DVeldhurthi/halflifeweek1/README.md

# Half-Life Week 1: Design a PCB

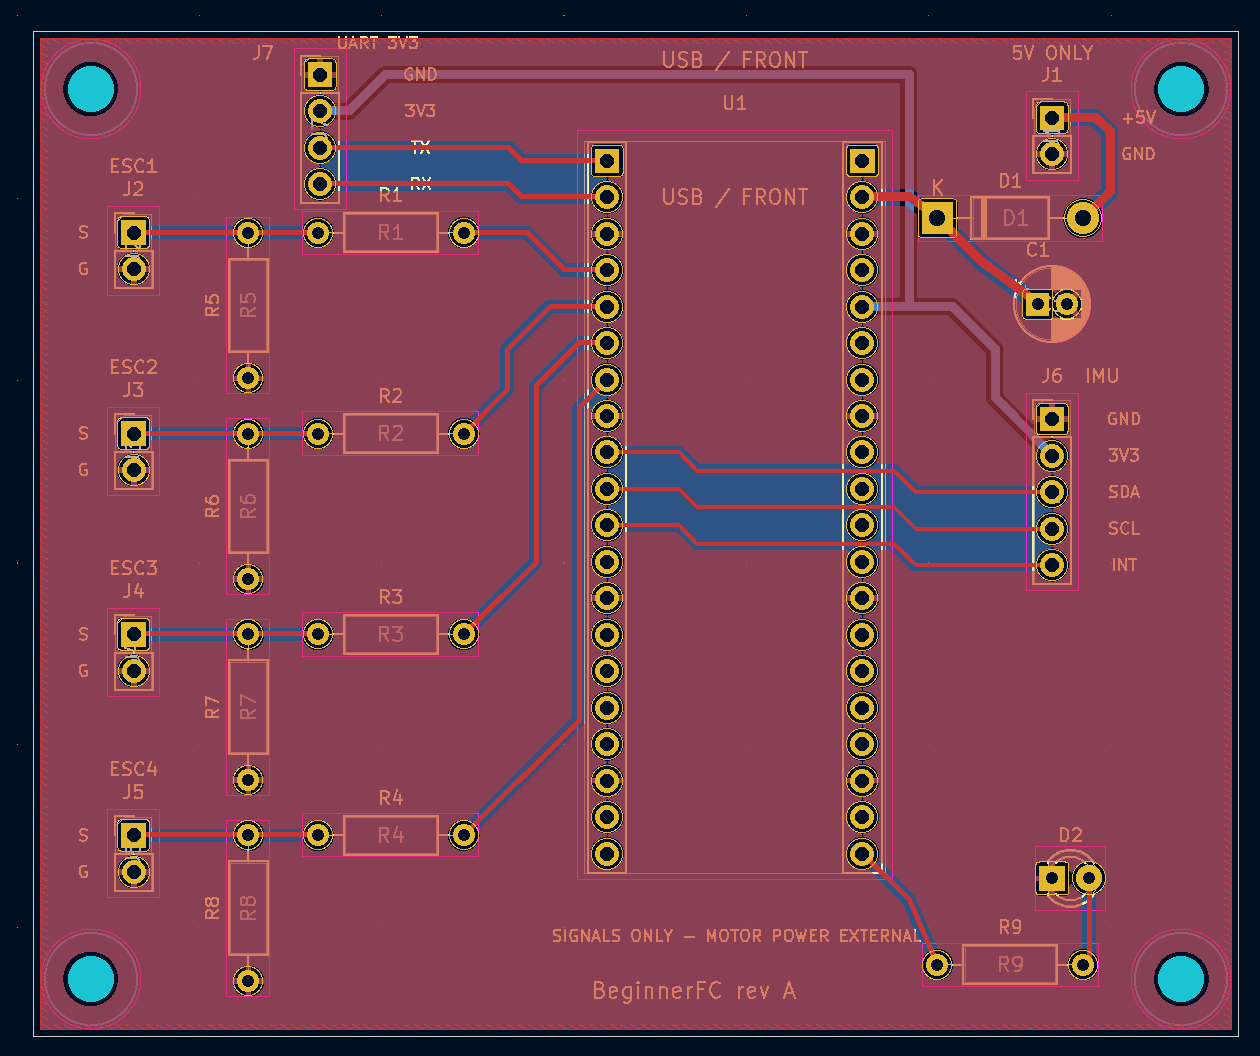
[picture p1: beginnerfc-board-layout.png]
Earlier two-layer BeginnerFC board layout


Earlier two-layer BeginnerFC layout. The current CAD files in this repository are the four-layer Week1 design.
