DVeldhurthi/halflifeweek1/JOURNAL.md

# Flight Control Drone – devlog

<!-- Generated by Half Life from project cmuvieabg00rr01ope0xkml5t. Edits here are overwritten on the next sync. -->
<!-- Generated: 2026-10-12T03:57:22.201Z -->

> [!NOTE]
> This devlog is mirrored from [Half Life](https://halflife.hackclub.com). Editing it here will not change the platform's copy, and the next sync overwrites this file.

> Its as the name says, the main pcb for a drone.

| Week | Tier | Hours logged | Entries |
| --- | --- | --- | --- |
| Week 1 | Tier 2 | 10h | 2 |

## Contents

1. [2026-10-11 – At this point, research is finished. All the components are also chosen. I also made the schematic, since it is not too hard. Then I spent a bit more time to check the schematic, and adding footprints](#2026-10-11-at-this-point-research-is-finished-all-the-compon)
2. [2026-10-11 – PCB routing is done. This part was espiecailly hard since I was trying to make it as light as possible becuase for a drone to fly, they need as much power in as little mass or weight as possible. So i](#2026-10-11-pcb-routing-is-done-this-part-was-espiecailly-har)

## Design

### 2026-10-11 – At this point, research is finished. All the components are also chosen. I also made the schematic, since it is not too hard. Then I spent a bit more time to check the schematic, and adding footprints

**8h**

At this point, research is finished. All the components are also chosen. I also made the schematic, since it is not too hard. Then I spent a bit more time to check the schematic, and adding footprints. Then I placed all the components, but no routing took place.

Screenshot 2026-10-11 at 8.50.39 PM

Screenshot 2026-10-11 at 8.50.52 PM

Screenshot 2026-10-11 at 8.51.08 PM

Screenshot 2026-10-11 at 8.51.21 PM

Screenshot 2026-10-11 at 8.51.37 PM

Screenshot 2026-10-11 at 8.51.44 PM

Screenshot 2026-10-11 at 8.51.52 PM

Screenshot 2026-10-11 at 8.52.00 PM

Screenshot 2026-10-11 at 8.52.20 PM

### 2026-10-11 – PCB routing is done. This part was espiecailly hard since I was trying to make it as light as possible becuase for a drone to fly, they need as much power in as little mass or weight as possible. So i

**2h**

PCB routing is done. This part was espiecailly hard since I was trying to make it as light as possible becuase for a drone to fly, they need as much power in as little mass or weight as possible. So it took  a while to do the pcb.

Screenshot 2026-10-11 at 8.56.25 PM

IM SOO PROUD OF MYSELF FOR THIS.
Screenshot 2026-10-11 at 8.57.04 PM
