DVeldhurthi/halflifeweek1/Week1.kicad_pcb

## KiCad design Week1.kicad_pcb (2026-10-12)

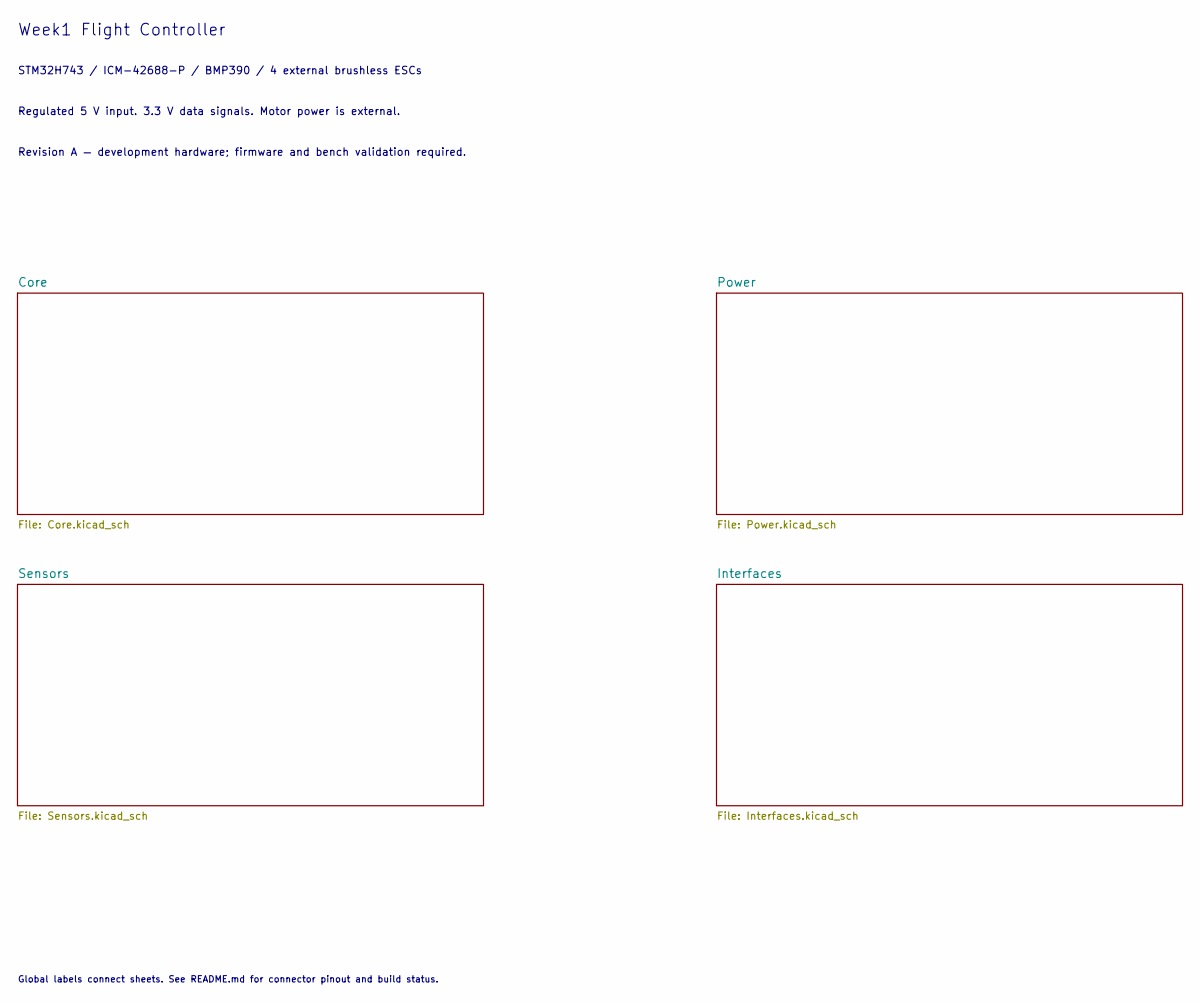
[picture p2: schematic Week1.kicad_sch, Week1 Flight Controller]

Notes on the sheet:
Week1 Flight Controller
STM32H743 / ICM-42688-P / BMP390 / 4 external brushless ESCs
Regulated 5 V input. 3.3 V data signals. Motor power is external.
Revision A — development hardware; firmware and bench validation required.
Global labels connect sheets. See README.md for connector pinout and build status.

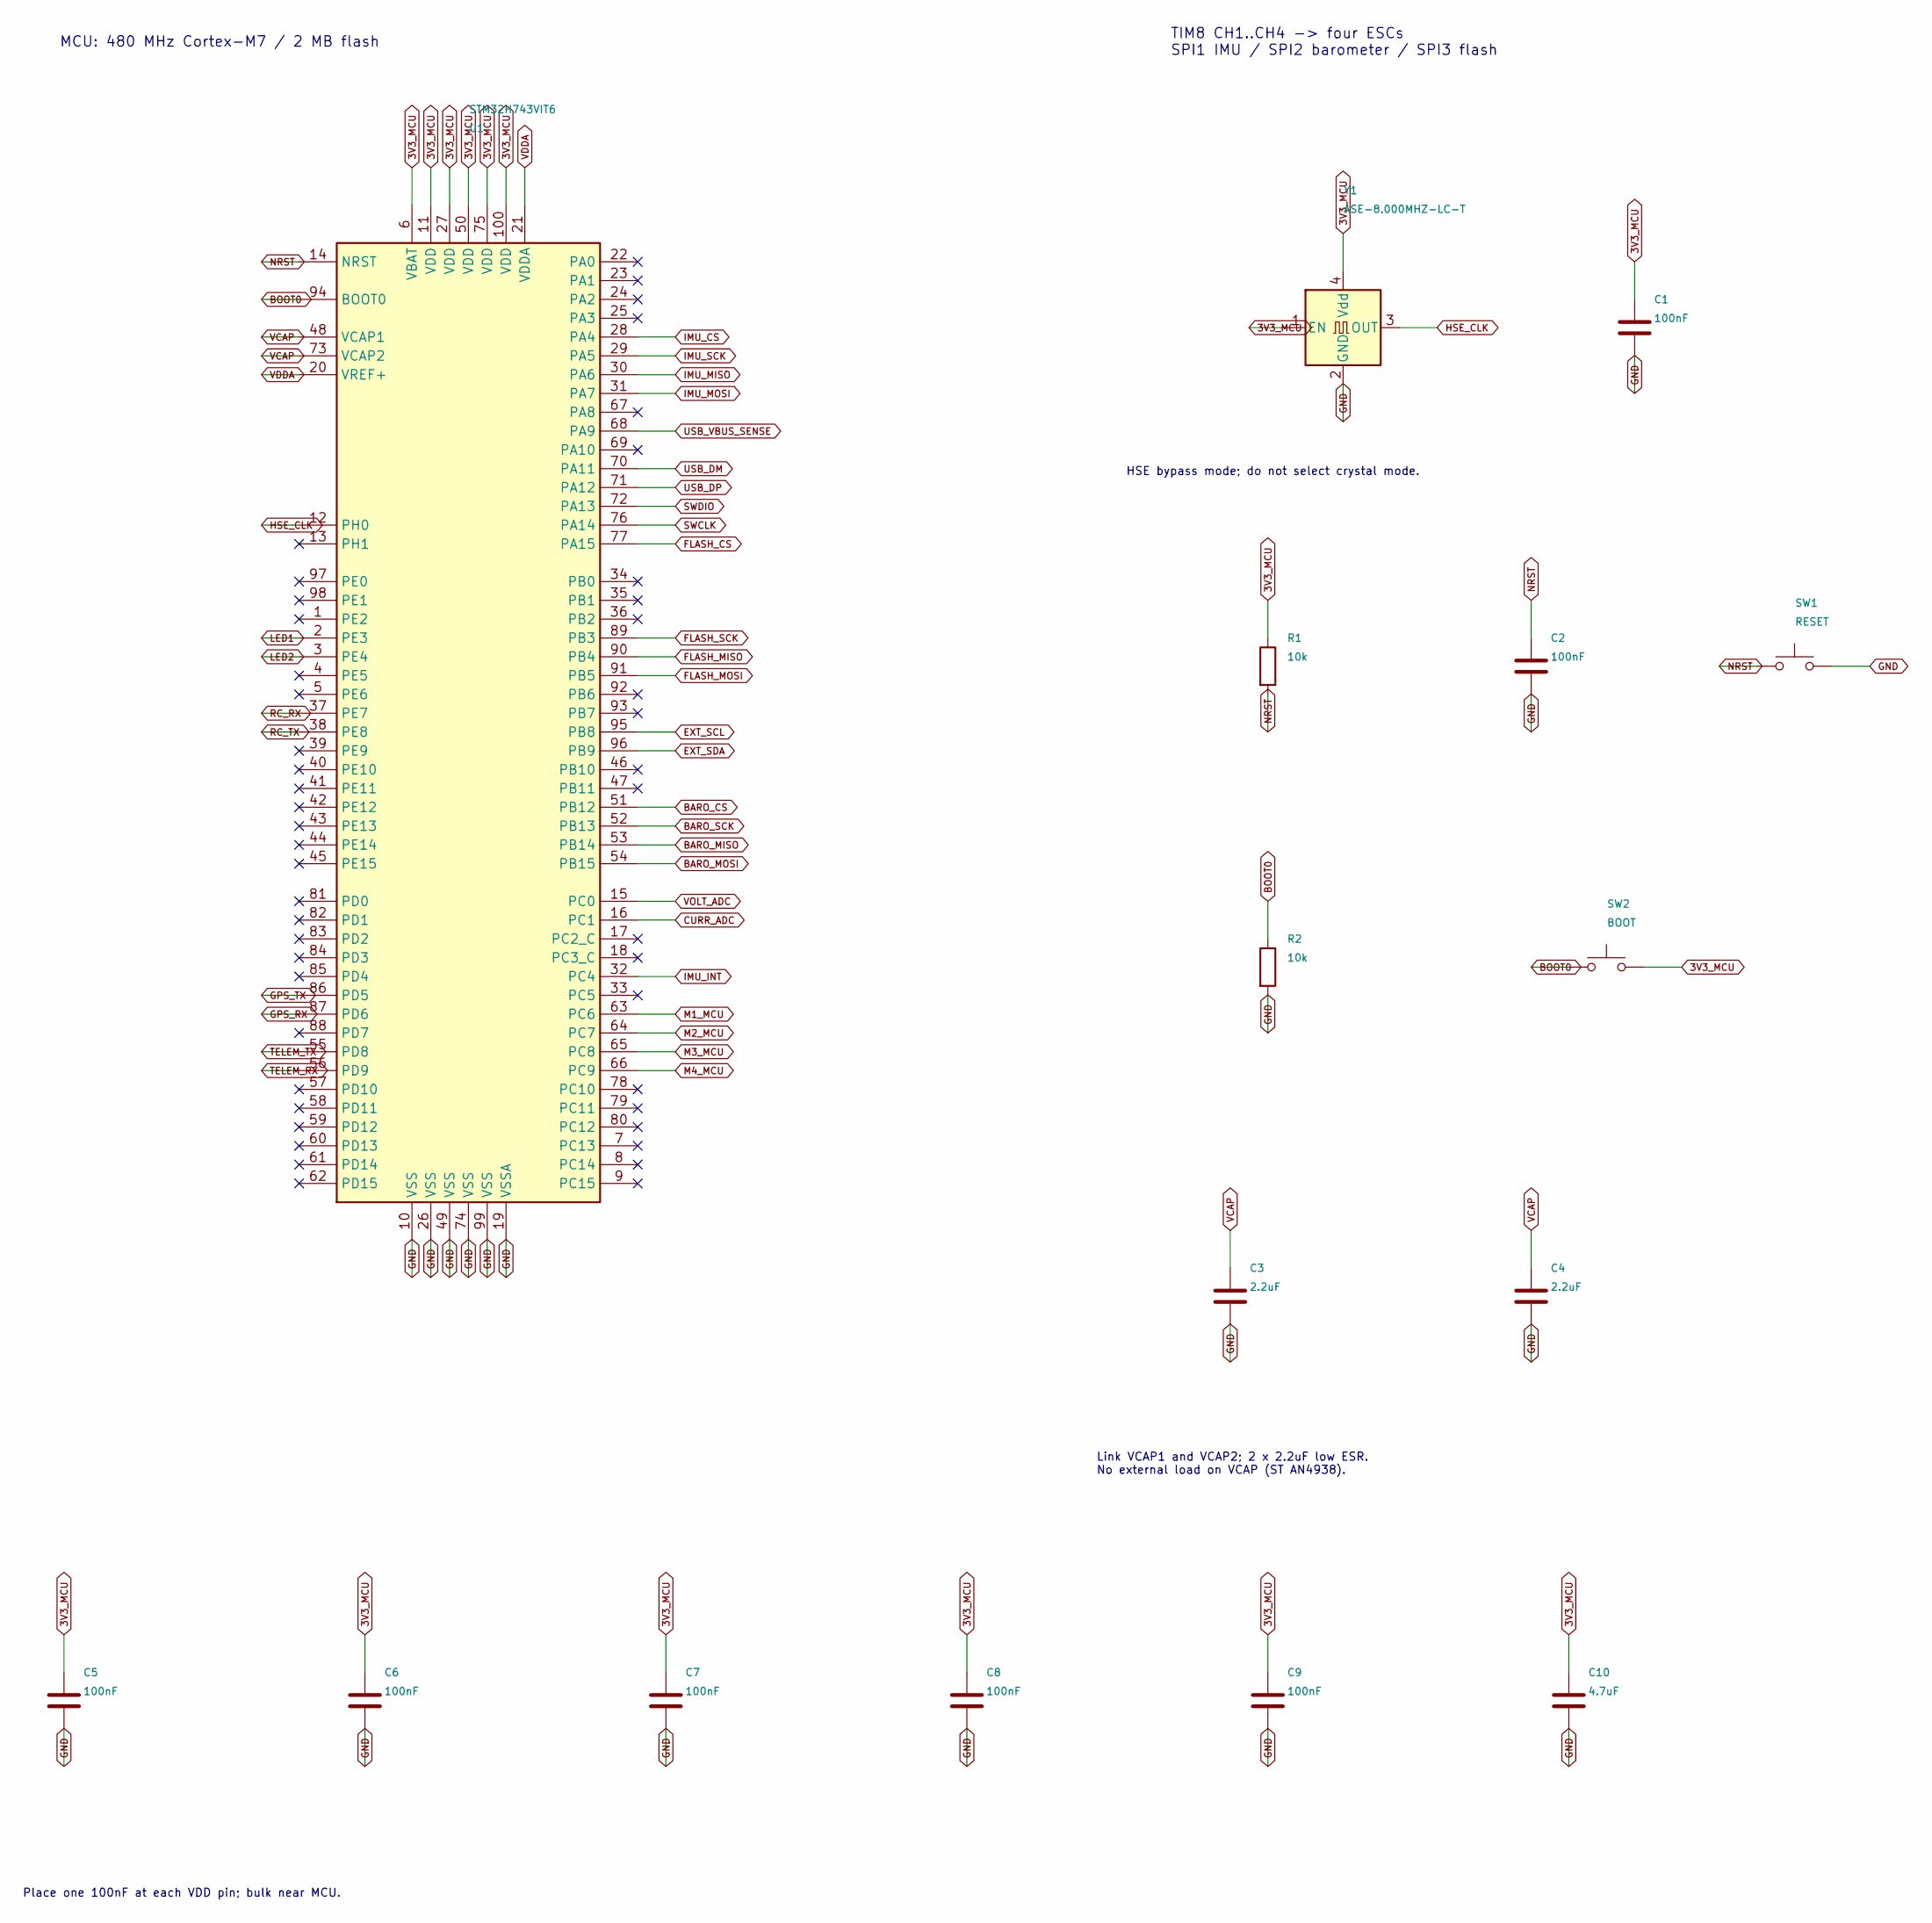
[picture p3: schematic Core.kicad_sch, Week1 — Core]

Parts:
C1, C2, C5, C6, C7, C8, C9: 100nF; C_0603_1608Metric
C3, C4: 2.2uF; C_0603_1608Metric
C10: 4.7uF; C_0603_1608Metric
R1, R2: 10k; R_0603_1608Metric
SW1: RESET; SW_SPST_TL3342
SW2: BOOT; SW_SPST_TL3342
U1: STM32H743VIT6; LQFP-100_14x14mm_P0.5mm
Y1: ASE-8.000MHZ-LC-T; Oscillator_SMD_Abracon_ASE-4Pin_3.2x2.5mm

Connections:
3V3_MCU: C1.1, C5.1, C6.1, C7.1, C8.1, C9.1, C10.1, R1.1, SW2.2, U1.6 (VBAT), U1.11 (VDD), U1.27 (VDD), U1.50 (VDD), U1.75 (VDD), U1.100 (VDD), Y1.1 (EN), Y1.4 (Vdd); also elsewhere on the board
BARO_CS: U1.51 (PB12); also elsewhere on the board
BARO_MISO: U1.53 (PB14); also elsewhere on the board
BARO_MOSI: U1.54 (PB15); also elsewhere on the board
BARO_SCK: U1.52 (PB13); also elsewhere on the board
BOOT0: R2.1, SW2.1, U1.94 (BOOT0)
CURR_ADC: U1.16 (PC1); also elsewhere on the board
EXT_SCL: U1.95 (PB8); also elsewhere on the board
EXT_SDA: U1.96 (PB9); also elsewhere on the board
FLASH_CS: U1.77 (PA15); also elsewhere on the board
FLASH_MISO: U1.90 (PB4); also elsewhere on the board
FLASH_MOSI: U1.91 (PB5); also elsewhere on the board
FLASH_SCK: U1.89 (PB3); also elsewhere on the board
GND: C1.2, C2.2, C3.2, C4.2, C5.2, C6.2, C7.2, C8.2, C9.2, C10.2, R2.2, SW1.2, U1.10 (VSS), U1.19 (VSSA), U1.26 (VSS), U1.49 (VSS), U1.74 (VSS), U1.99 (VSS), Y1.2 (GND); also elsewhere on the board
GPS_RX: U1.87 (PD6); also elsewhere on the board
GPS_TX: U1.86 (PD5); also elsewhere on the board
HSE_CLK: U1.12 (PH0), Y1.3 (OUT)
IMU_CS: U1.28 (PA4); also elsewhere on the board
IMU_INT: U1.32 (PC4); also elsewhere on the board
IMU_MISO: U1.30 (PA6); also elsewhere on the board
IMU_MOSI: U1.31 (PA7); also elsewhere on the board
IMU_SCK: U1.29 (PA5); also elsewhere on the board
LED1: U1.2 (PE3); also elsewhere on the board
LED2: U1.3 (PE4); also elsewhere on the board
M1_MCU: U1.63 (PC6); also elsewhere on the board
M2_MCU: U1.64 (PC7); also elsewhere on the board
M3_MCU: U1.65 (PC8); also elsewhere on the board
M4_MCU: U1.66 (PC9); also elsewhere on the board
NRST: C2.1, R1.2, SW1.1, U1.14 (NRST); also elsewhere on the board
RC_RX: U1.37 (PE7); also elsewhere on the board
RC_TX: U1.38 (PE8); also elsewhere on the board
SWCLK: U1.76 (PA14); also elsewhere on the board
SWDIO: U1.72 (PA13); also elsewhere on the board
TELEM_RX: U1.56 (PD9); also elsewhere on the board
TELEM_TX: U1.55 (PD8); also elsewhere on the board
USB_DM: U1.70 (PA11); also elsewhere on the board
USB_DP: U1.71 (PA12); also elsewhere on the board
USB_VBUS_SENSE: U1.68 (PA9); also elsewhere on the board
VCAP: C3.1, C4.1, U1.48 (VCAP1), U1.73 (VCAP2)
VDDA: U1.20 (VREF+), U1.21 (VDDA); also elsewhere on the board
VOLT_ADC: U1.15 (PC0); also elsewhere on the board

Notes on the sheet:
MCU: 480 MHz Cortex-M7 / 2 MB flash
TIM8 CH1..CH4 -> four ESCs SPI1 IMU / SPI2 barometer / SPI3 flash
HSE bypass mode; do not select crystal mode.
Link VCAP1 and VCAP2; 2 x 2.2uF low ESR. No external load on VCAP (ST AN4938).
Place one 100nF at each VDD pin; bulk near MCU.

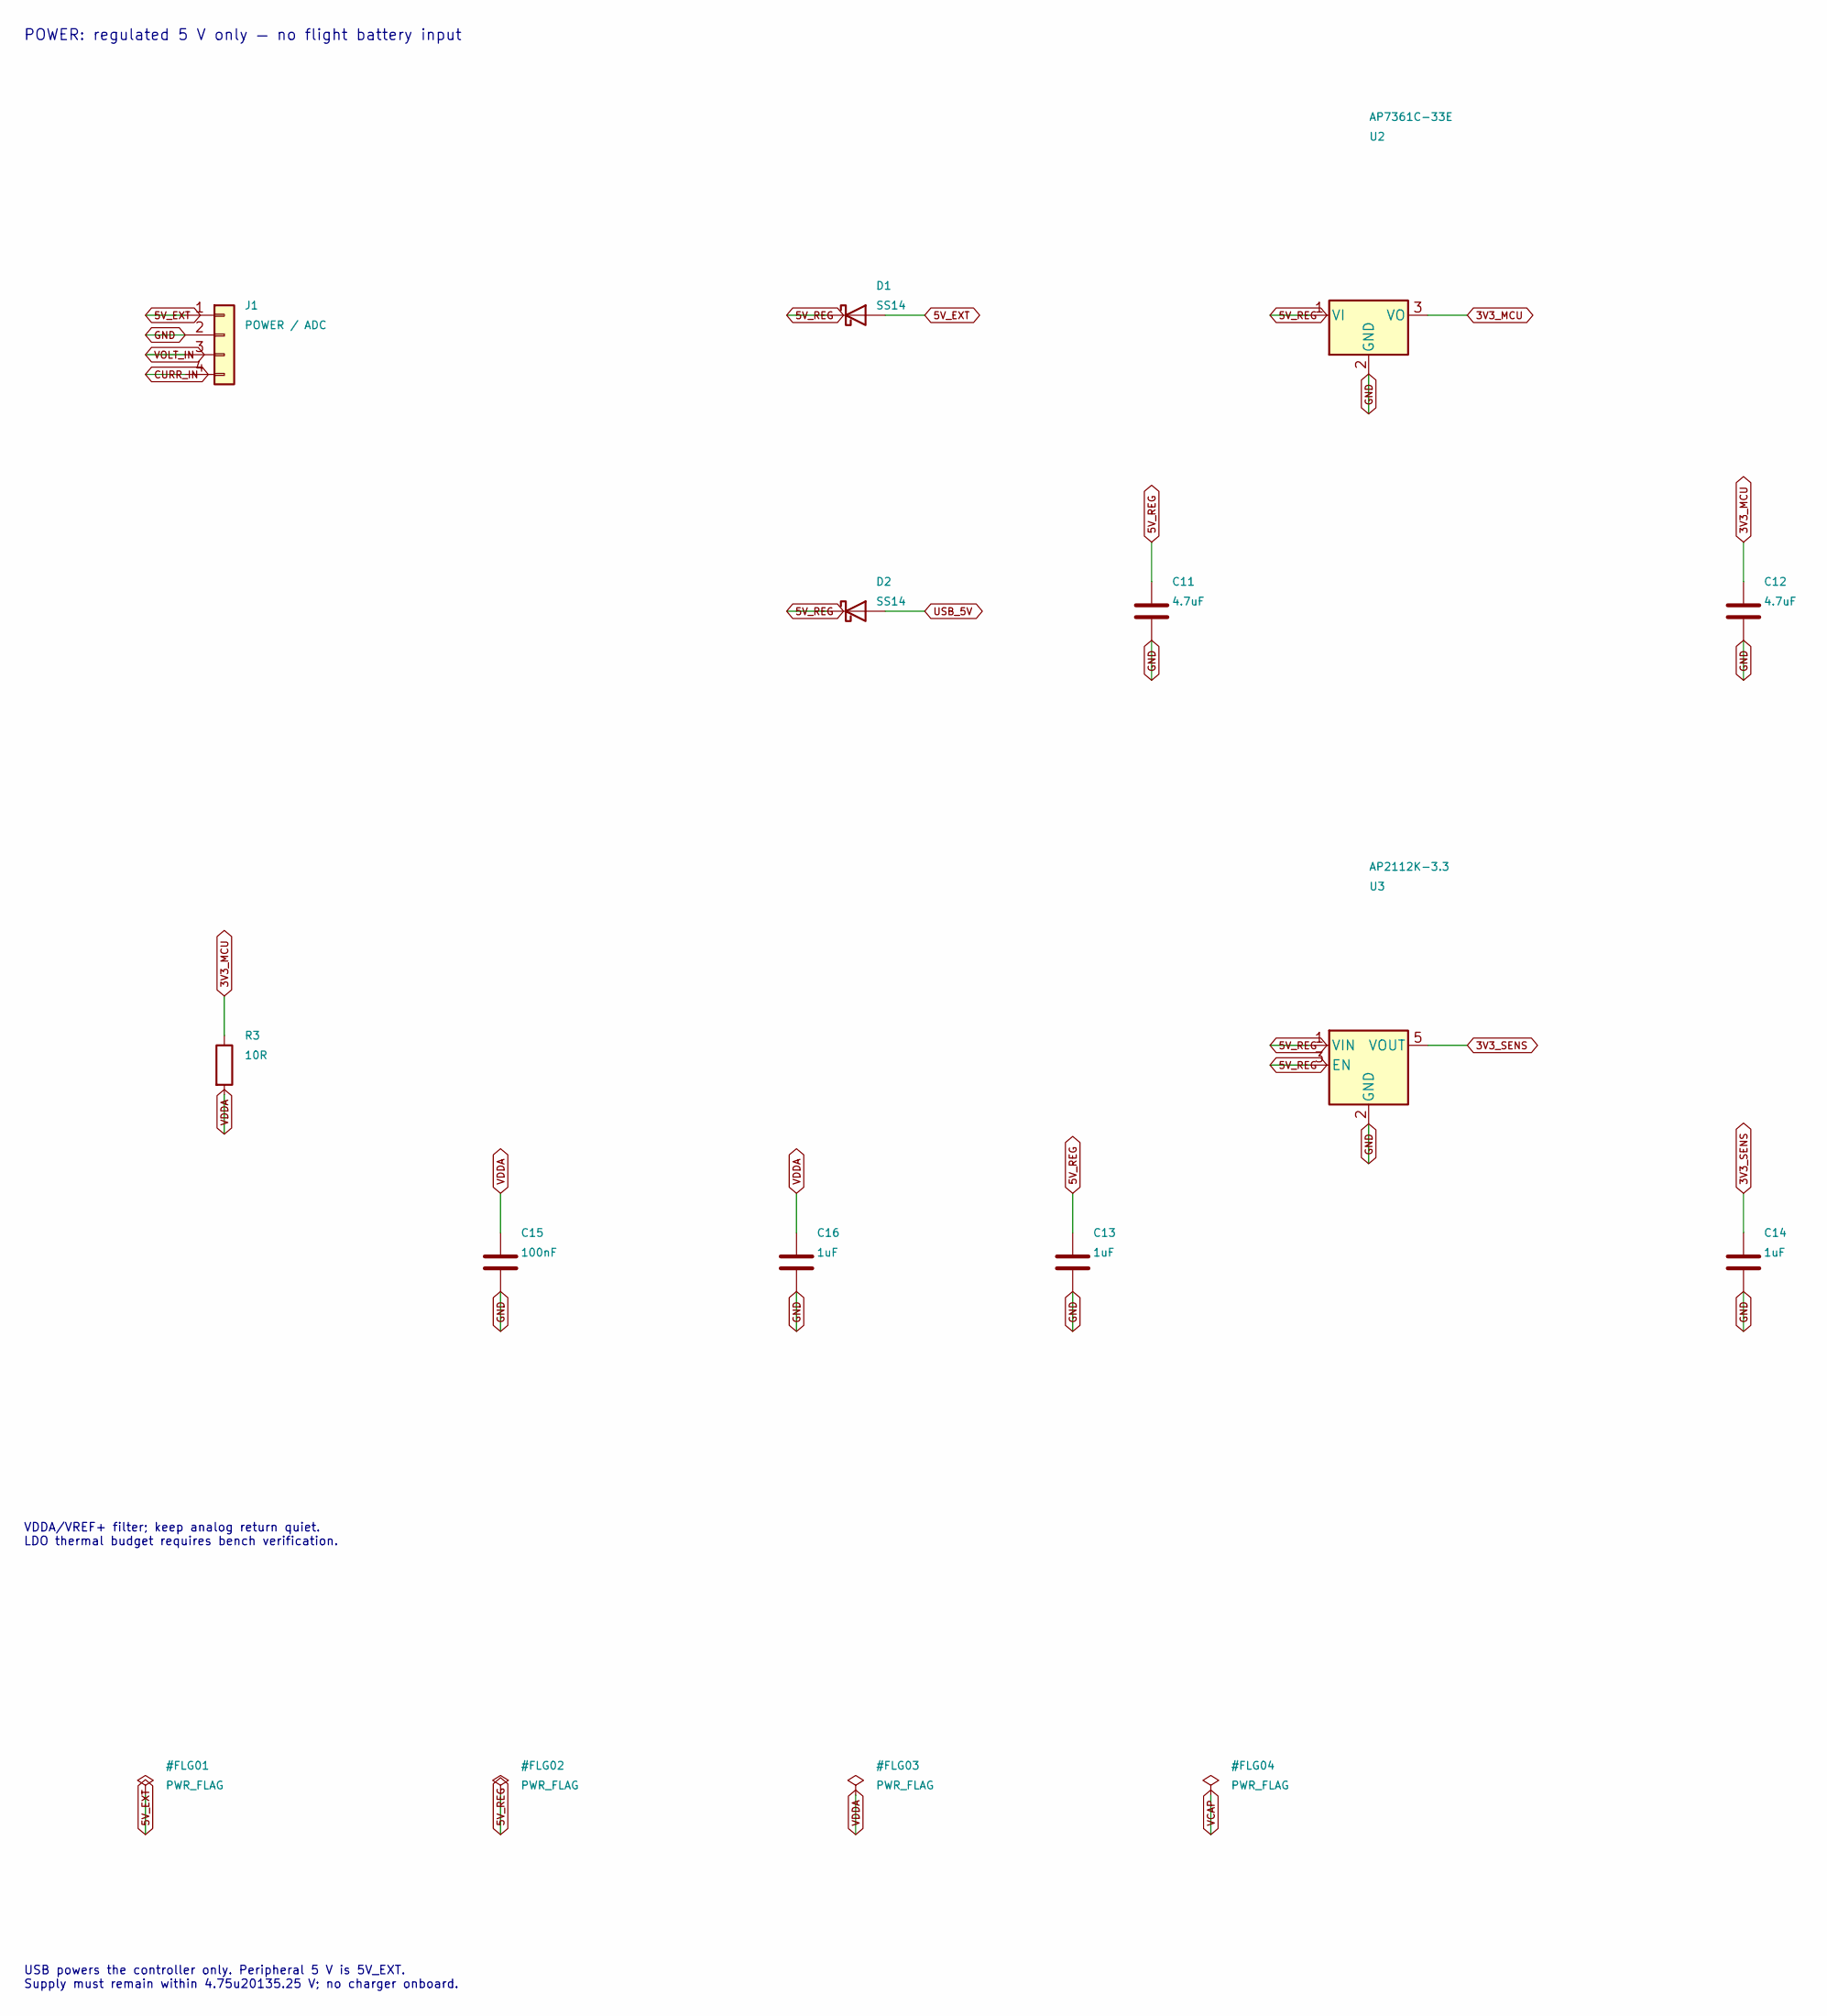
[picture p4: schematic Power.kicad_sch, Week1 — Power]

Parts:
C11, C12: 4.7uF; C_0603_1608Metric
C13, C14, C16: 1uF; C_0603_1608Metric
C15: 100nF; C_0603_1608Metric
D1, D2: SS14; D_SMA
J1: POWER / ADC; JST_GH_SM04B-GHS-TB_1x04-1MP_P1.25mm_Horizontal
R3: 10R; R_0603_1608Metric
U2: AP7361C-33E; SOT-223-3_TabPin2
U3: AP2112K-3.3; SOT-23-5

Connections:
3V3_MCU: C12.1, R3.1, U2.3 (VO); also elsewhere on the board
3V3_SENS: C14.1, U3.5 (VOUT); also elsewhere on the board
5V_EXT: D1.2 (A), J1.1; also elsewhere on the board
5V_REG: C11.1, C13.1, D1.1 (K), D2.1 (K), U2.1 (VI), U3.1 (VIN), U3.3 (EN)
CURR_IN: J1.4; also elsewhere on the board
GND: C11.2, C12.2, C13.2, C14.2, C15.2, C16.2, J1.2, U2.2 (GND), U3.2 (GND); also elsewhere on the board
USB_5V: D2.2 (A); also elsewhere on the board
VDDA: C15.1, C16.1, R3.2; also elsewhere on the board
VOLT_IN: J1.3; also elsewhere on the board

Notes on the sheet:
POWER: regulated 5 V only — no flight battery input
VDDA/VREF+ filter; keep analog return quiet. LDO thermal budget requires bench verification.
USB powers the controller only. Peripheral 5 V is 5V_EXT. Supply must remain within 4.75u20135.25 V; no charger onboard.

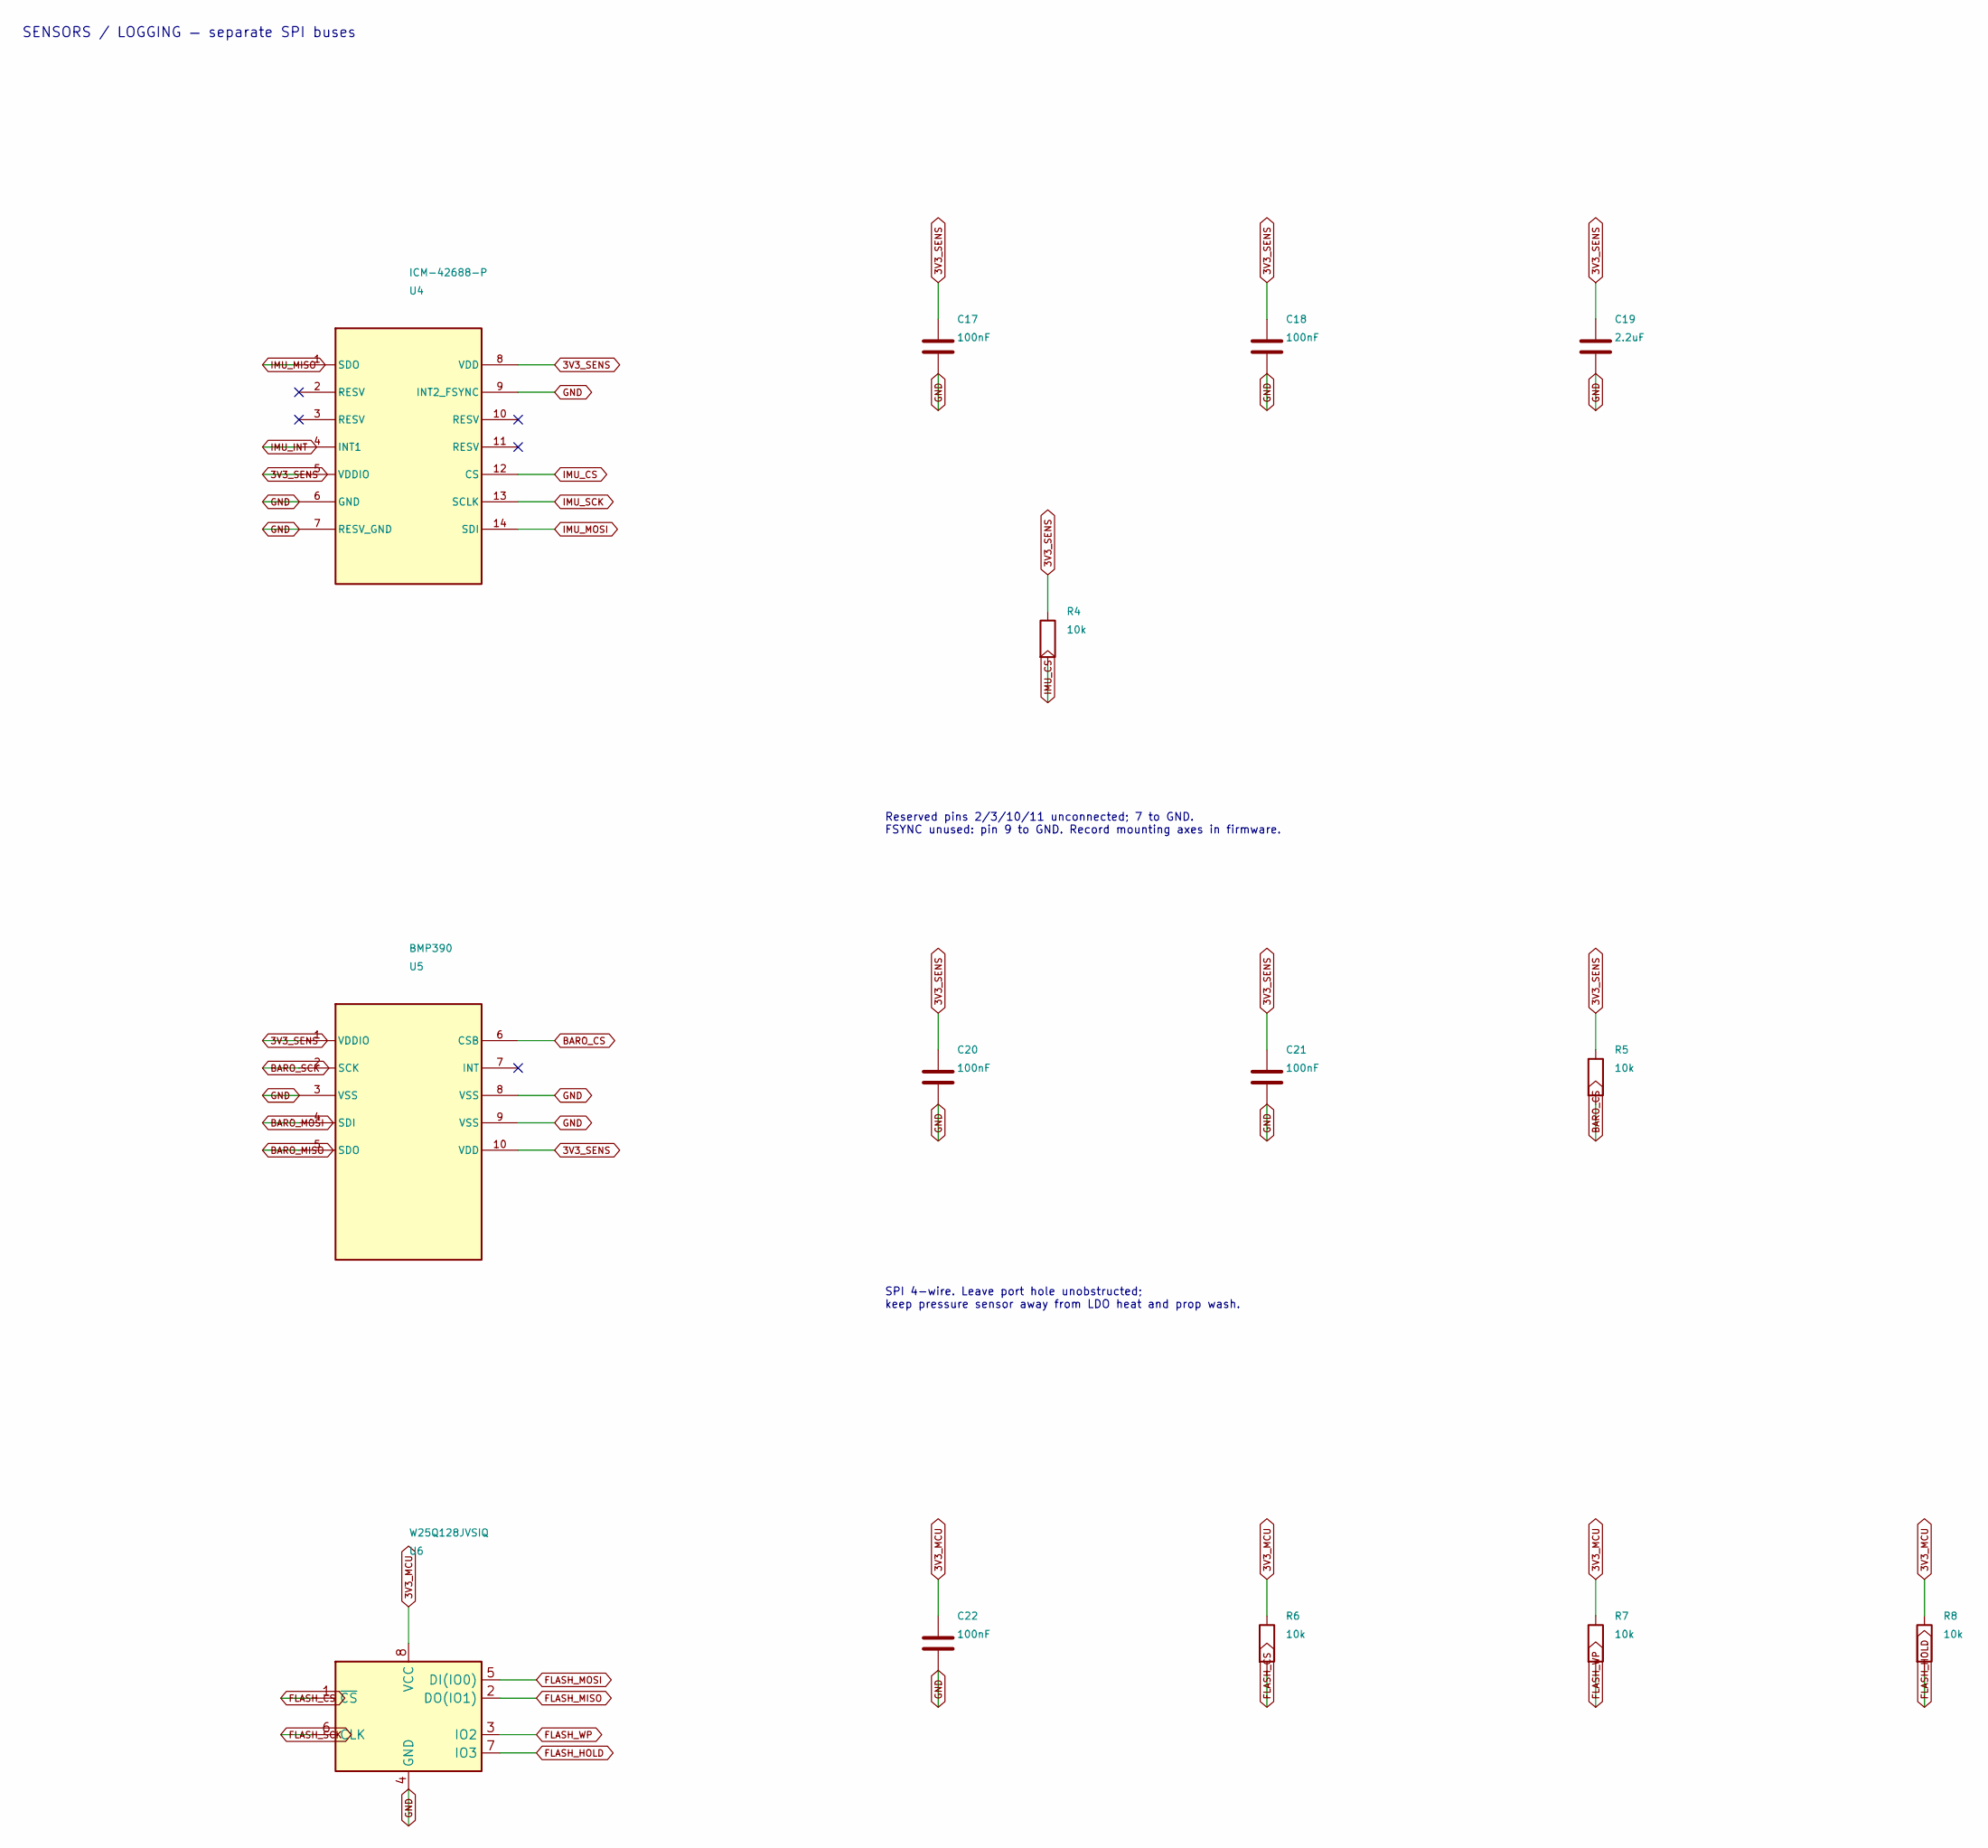
[picture p5: schematic Sensors.kicad_sch, Week1 — Sensors]

Parts:
C17, C18, C20, C21, C22: 100nF; C_0603_1608Metric
C19: 2.2uF; C_0603_1608Metric
R4, R5, R6, R7, R8: 10k; R_0603_1608Metric
U4: ICM-42688-P
U5: BMP390
U6: W25Q128JVSIQ; SOIC-8_5.23x5.23mm_P1.27mm

Connections:
3V3_MCU: C22.1, R6.1, R7.1, R8.1, U6.8 (VCC); also elsewhere on the board
3V3_SENS: C17.1, C18.1, C19.1, C20.1, C21.1, R4.1, R5.1, U4.5 (VDDIO), U4.8 (VDD), U5.1 (VDDIO), U5.10 (VDD); also elsewhere on the board
BARO_CS: R5.2, U5.6 (CSB); also elsewhere on the board
BARO_MISO: U5.5 (SDO); also elsewhere on the board
BARO_MOSI: U5.4 (SDI); also elsewhere on the board
BARO_SCK: U5.2 (SCK); also elsewhere on the board
FLASH_CS: R6.2, U6.1 (~CS); also elsewhere on the board
FLASH_HOLD: R8.2, U6.7 (IO3)
FLASH_MISO: U6.2 (DO(IO1)); also elsewhere on the board
FLASH_MOSI: U6.5 (DI(IO0)); also elsewhere on the board
FLASH_SCK: U6.6 (CLK); also elsewhere on the board
FLASH_WP: R7.2, U6.3 (IO2)
GND: C17.2, C18.2, C19.2, C20.2, C21.2, C22.2, U4.6 (GND), U4.7 (RESV_GND), U4.9 (INT2_FSYNC), U5.3 (VSS), U5.8 (VSS), U5.9 (VSS), U6.4 (GND); also elsewhere on the board
IMU_CS: R4.2, U4.12 (CS); also elsewhere on the board
IMU_INT: U4.4 (INT1); also elsewhere on the board
IMU_MISO: U4.1 (SDO); also elsewhere on the board
IMU_MOSI: U4.14 (SDI); also elsewhere on the board
IMU_SCK: U4.13 (SCLK); also elsewhere on the board

Notes on the sheet:
SENSORS / LOGGING — separate SPI buses
Reserved pins 2/3/10/11 unconnected; 7 to GND. FSYNC unused: pin 9 to GND. Record mounting axes in firmware.
SPI 4-wire. Leave port hole unobstructed; keep pressure sensor away from LDO heat and prop wash.
