DVeldhurthi/halflifeweek1/Week1.kicad_pcb

## KiCad design Week1.kicad_pcb (continued)

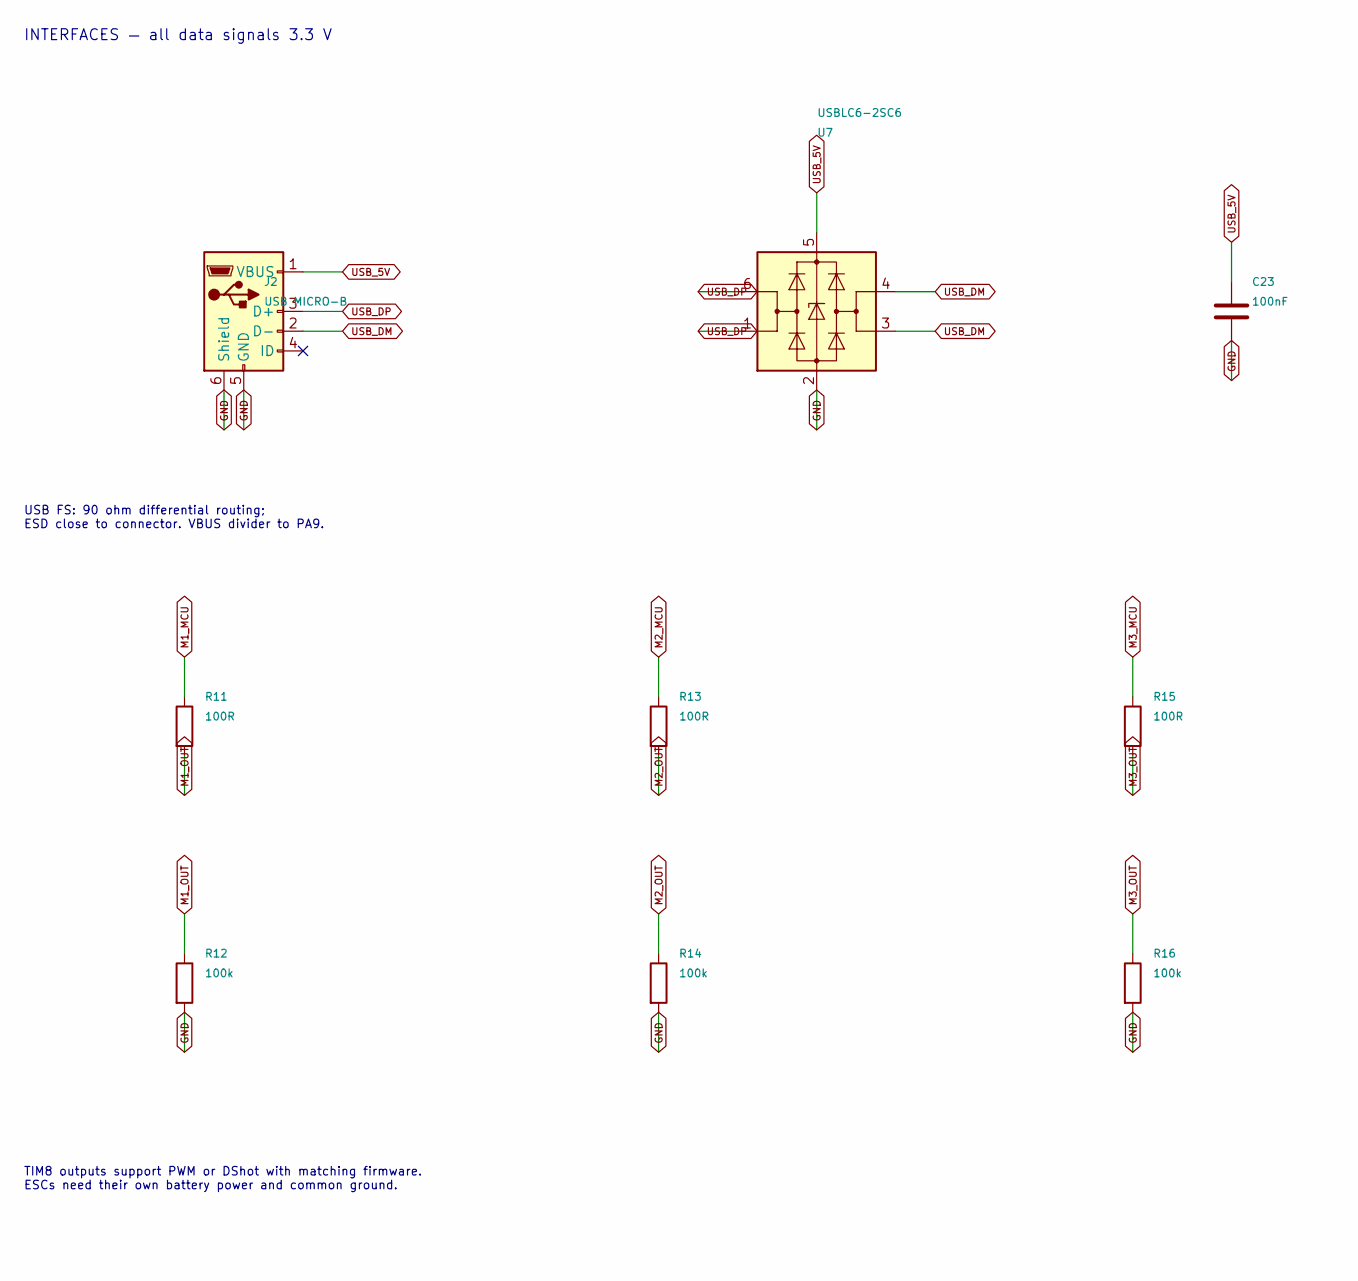
[picture p6: schematic Interfaces.kicad_sch, Week1 — Interfaces, part in row 1, column 1]

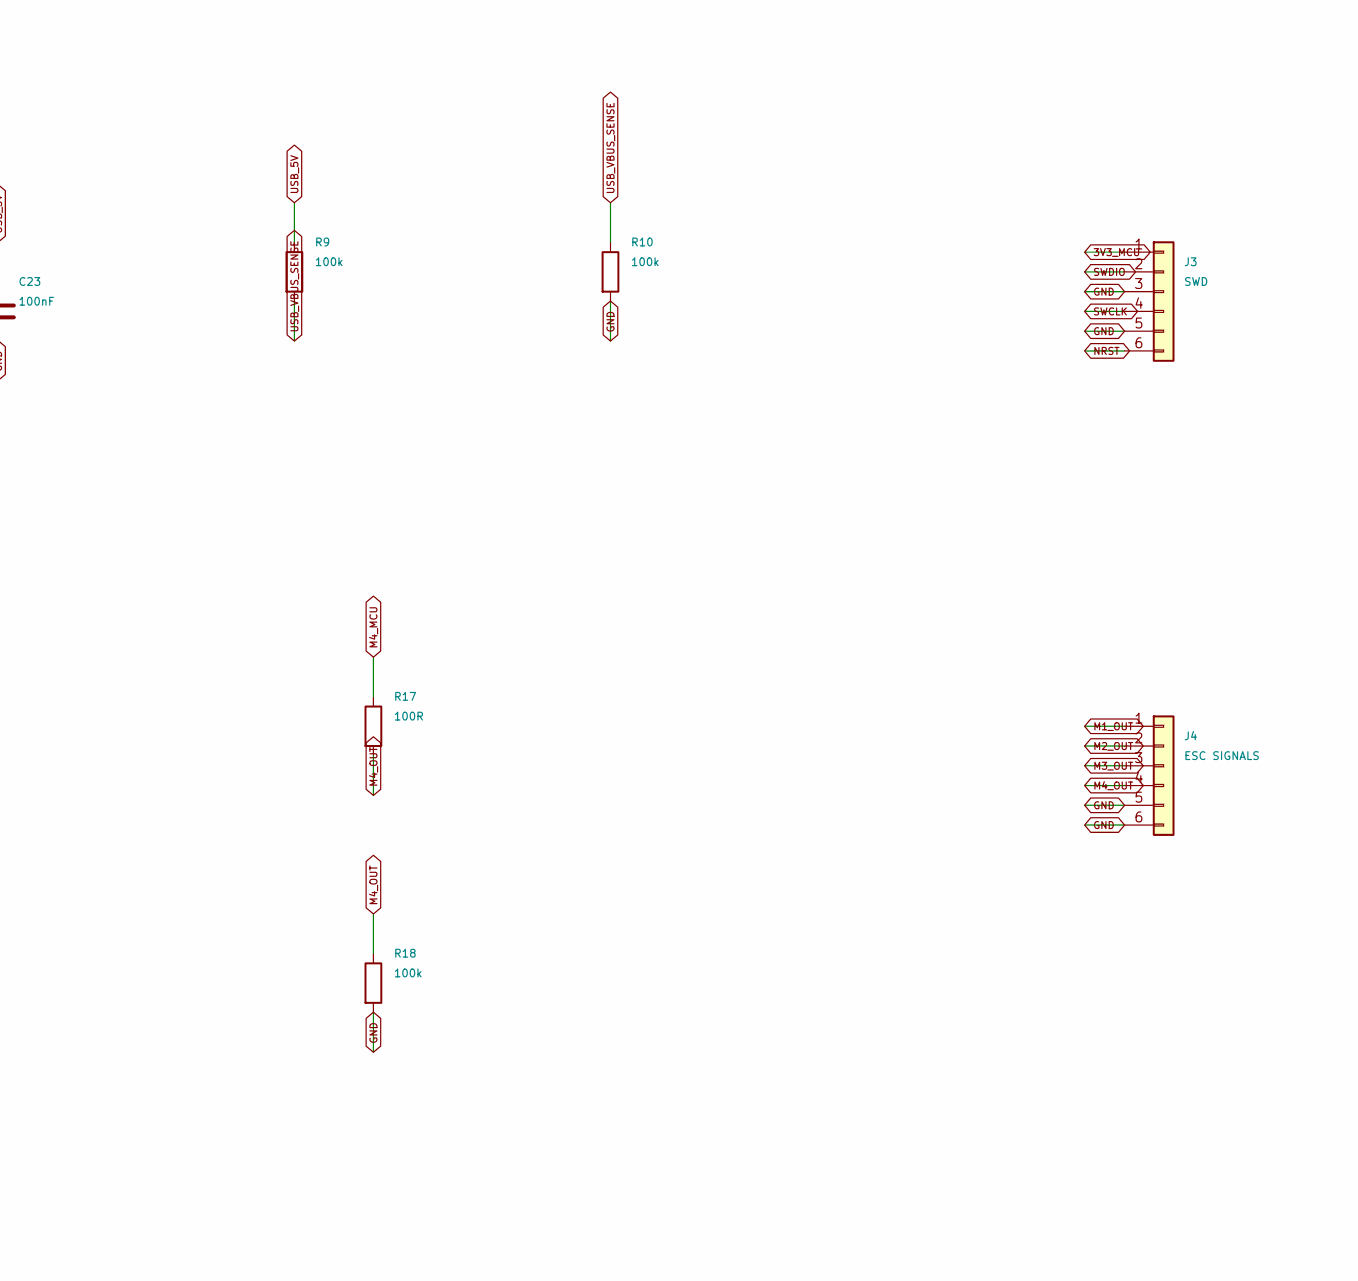
[picture p7: schematic Interfaces.kicad_sch, Week1 — Interfaces, part in row 1, column 2]

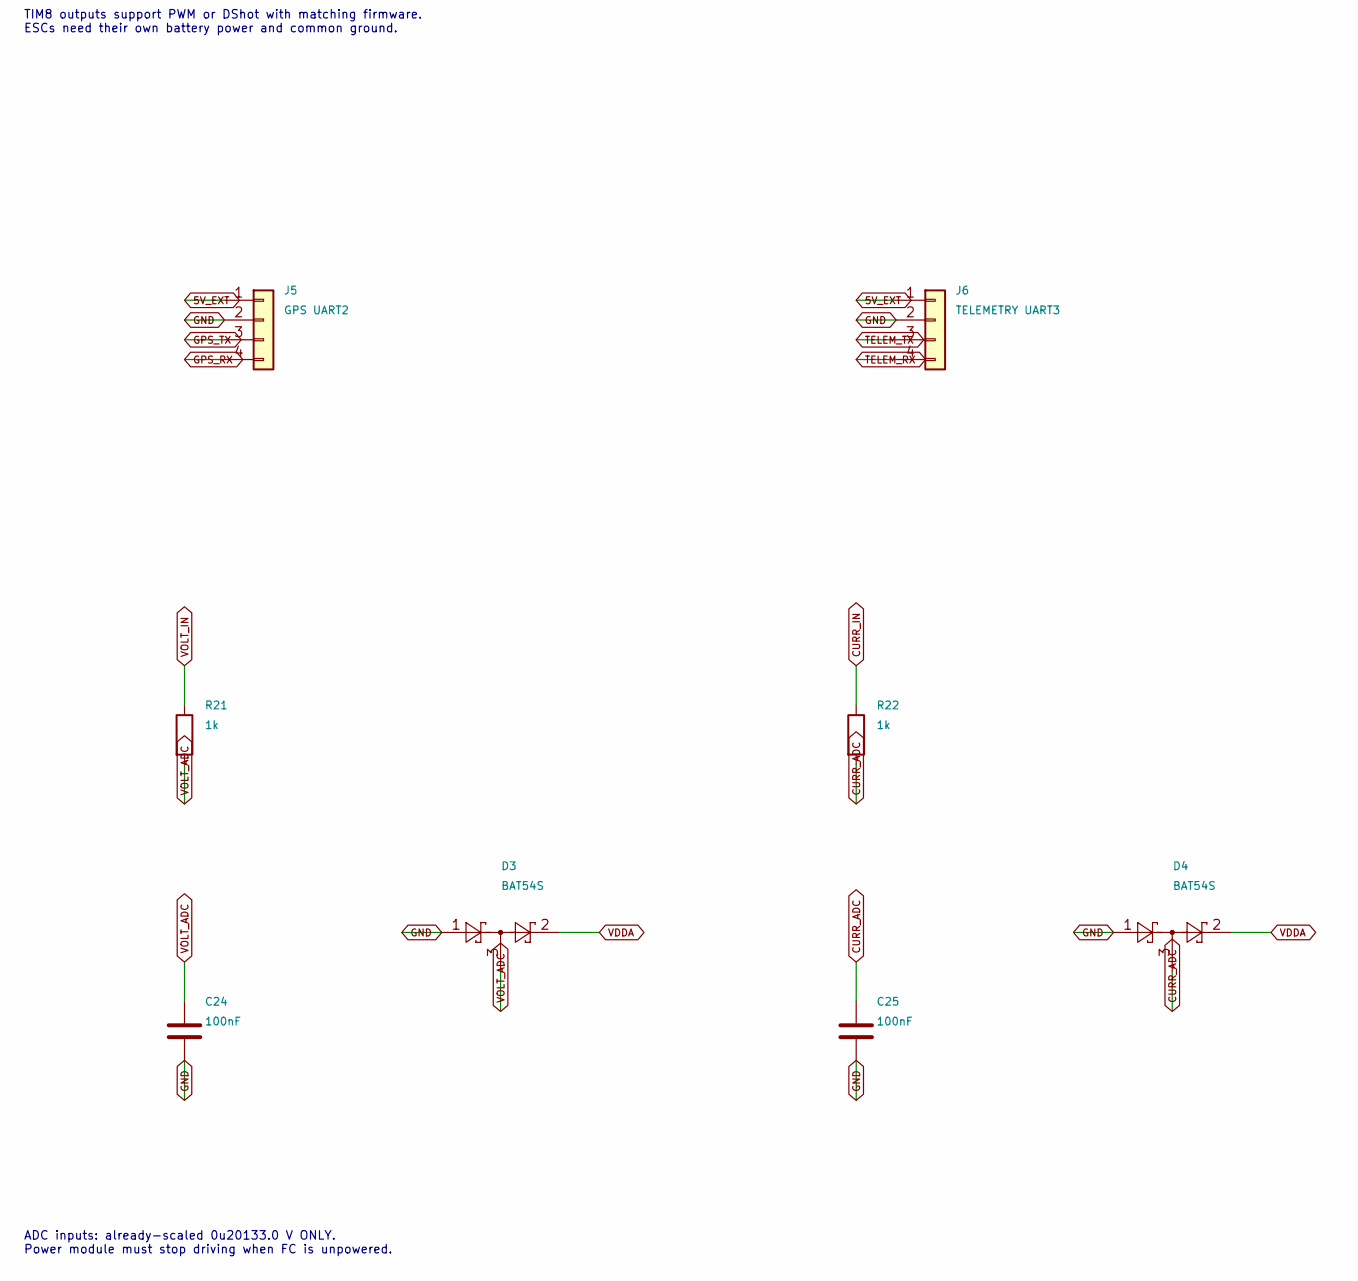
[picture p8: schematic Interfaces.kicad_sch, Week1 — Interfaces, part in row 2, column 1]

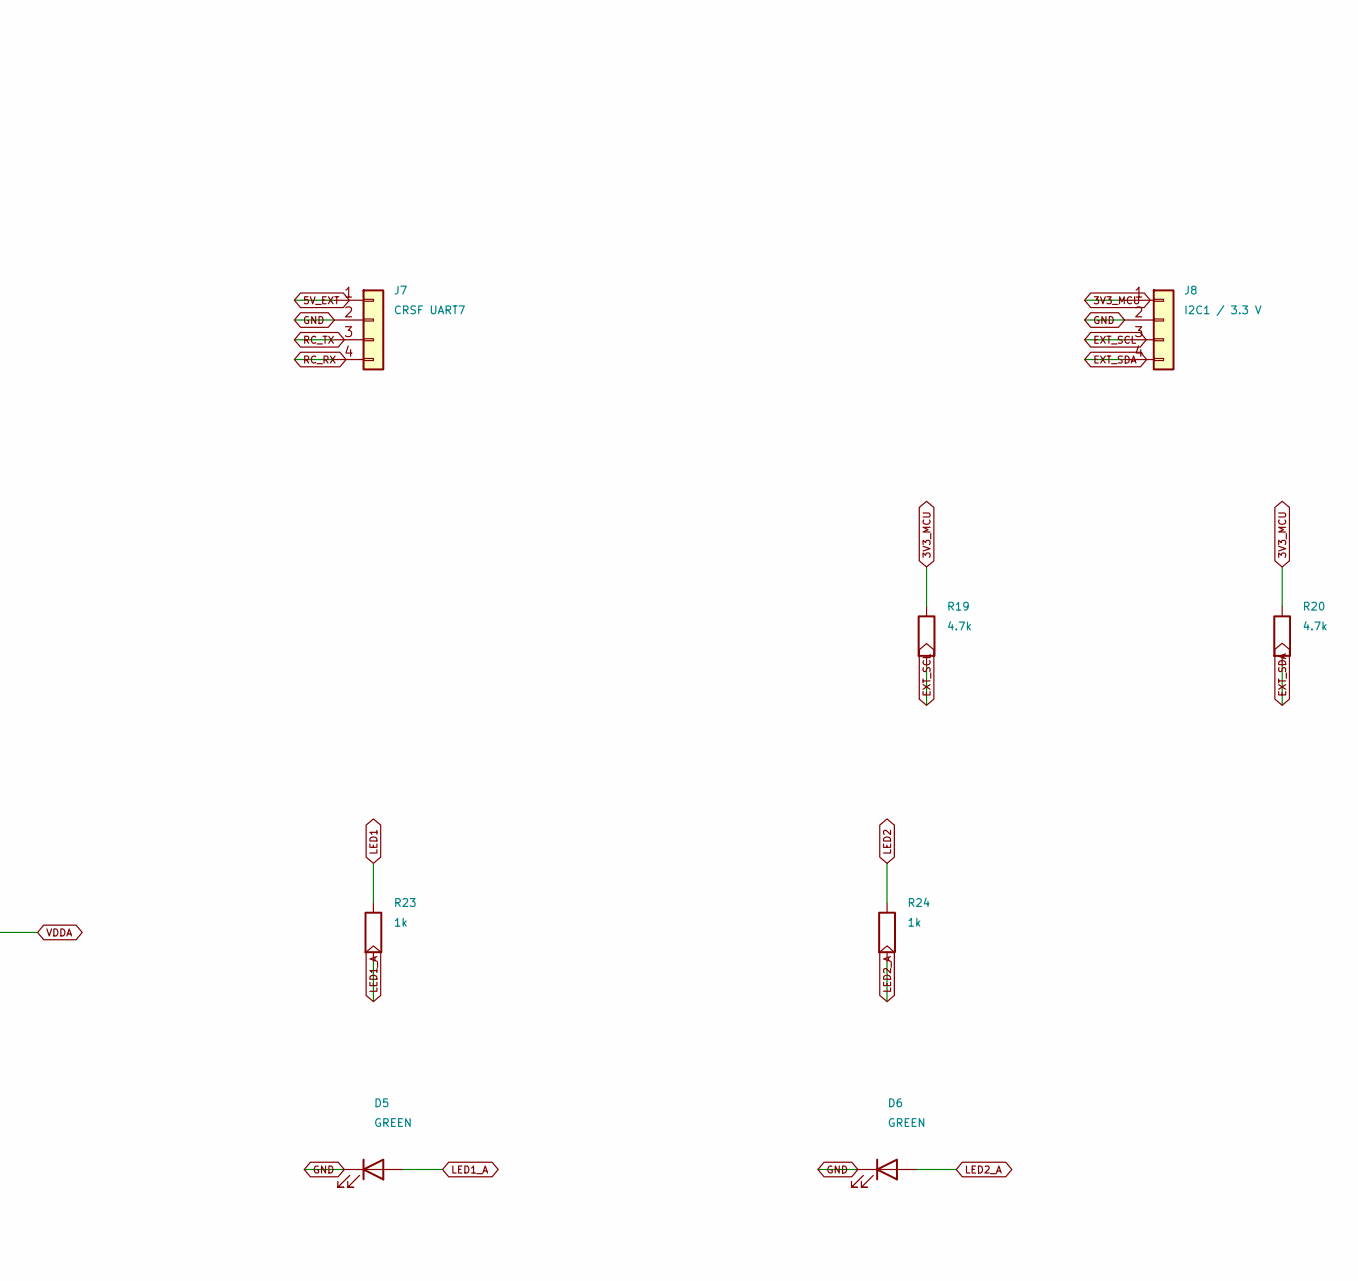
[picture p9: schematic Interfaces.kicad_sch, Week1 — Interfaces, part in row 2, column 2]

Parts:
C23, C24, C25: 100nF; C_0603_1608Metric
D3, D4: BAT54S; SOT-23
D5, D6: GREEN; LED_0603_1608Metric
J2: USB MICRO-B; USB_Micro-B_Amphenol_10118194_Horizontal
J3: SWD; PinHeader_1x06_P1.27mm_Vertical
J4: ESC SIGNALS; JST_GH_SM06B-GHS-TB_1x06-1MP_P1.25mm_Horizontal
J5: GPS UART2; JST_GH_SM04B-GHS-TB_1x04-1MP_P1.25mm_Horizontal
J6: TELEMETRY UART3; JST_GH_SM04B-GHS-TB_1x04-1MP_P1.25mm_Horizontal
J7: CRSF UART7; JST_GH_SM04B-GHS-TB_1x04-1MP_P1.25mm_Horizontal
J8: I2C1 / 3.3 V; JST_GH_SM04B-GHS-TB_1x04-1MP_P1.25mm_Horizontal
R9, R10, R12, R14, R16, R18: 100k; R_0603_1608Metric
R11, R13, R15, R17: 100R; R_0603_1608Metric
R19, R20: 4.7k; R_0603_1608Metric
R21, R22, R23, R24: 1k; R_0603_1608Metric
U7: USBLC6-2SC6; SOT-23-6

Connections:
3V3_MCU: J3.1, J8.1, R19.1, R20.1; also elsewhere on the board
5V_EXT: J5.1, J6.1, J7.1; also elsewhere on the board
CURR_ADC: C25.1, D4.3, R22.2; also elsewhere on the board
CURR_IN: R22.1; also elsewhere on the board
EXT_SCL: J8.3, R19.2; also elsewhere on the board
EXT_SDA: J8.4, R20.2; also elsewhere on the board
GND: C23.2, C24.2, C25.2, D3.1, D4.1, D5.1 (K), D6.1 (K), J2.5 (GND), J2.6 (Shield), J3.3, J3.5, J4.5, J4.6, J5.2, J6.2, J7.2, J8.2, R10.2, R12.2, R14.2, R16.2, R18.2, U7.2 (GND); also elsewhere on the board
GPS_RX: J5.4; also elsewhere on the board
GPS_TX: J5.3; also elsewhere on the board
LED1: R23.1; also elsewhere on the board
LED1_A: D5.2 (A), R23.2
LED2: R24.1; also elsewhere on the board
LED2_A: D6.2 (A), R24.2
M1_MCU: R11.1; also elsewhere on the board
M1_OUT: J4.1, R11.2, R12.1
M2_MCU: R13.1; also elsewhere on the board
M2_OUT: J4.2, R13.2, R14.1
M3_MCU: R15.1; also elsewhere on the board
M3_OUT: J4.3, R15.2, R16.1
M4_MCU: R17.1; also elsewhere on the board
M4_OUT: J4.4, R17.2, R18.1
NRST: J3.6; also elsewhere on the board
RC_RX: J7.4; also elsewhere on the board
RC_TX: J7.3; also elsewhere on the board
SWCLK: J3.4; also elsewhere on the board
SWDIO: J3.2; also elsewhere on the board
TELEM_RX: J6.4; also elsewhere on the board
TELEM_TX: J6.3; also elsewhere on the board
USB_5V: C23.1, J2.1 (VBUS), R9.1, U7.5 (VBUS); also elsewhere on the board
USB_DM: J2.2 (D-), U7.3 (I/O2), U7.4 (I/O2); also elsewhere on the board
USB_DP: J2.3 (D+), U7.1 (I/O1), U7.6 (I/O1); also elsewhere on the board
USB_VBUS_SENSE: R9.2, R10.1; also elsewhere on the board
VDDA: D3.2, D4.2; also elsewhere on the board
VOLT_ADC: C24.1, D3.3, R21.2; also elsewhere on the board
VOLT_IN: R21.1; also elsewhere on the board

Notes on the sheet:
INTERFACES — all data signals 3.3 V
USB FS: 90 ohm differential routing; ESD close to connector. VBUS divider to PA9.
TIM8 outputs support PWM or DShot with matching firmware. ESCs need their own battery power and common ground.
ADC inputs: already-scaled 0u20133.0 V ONLY. Power module must stop driving when FC is unpowered.

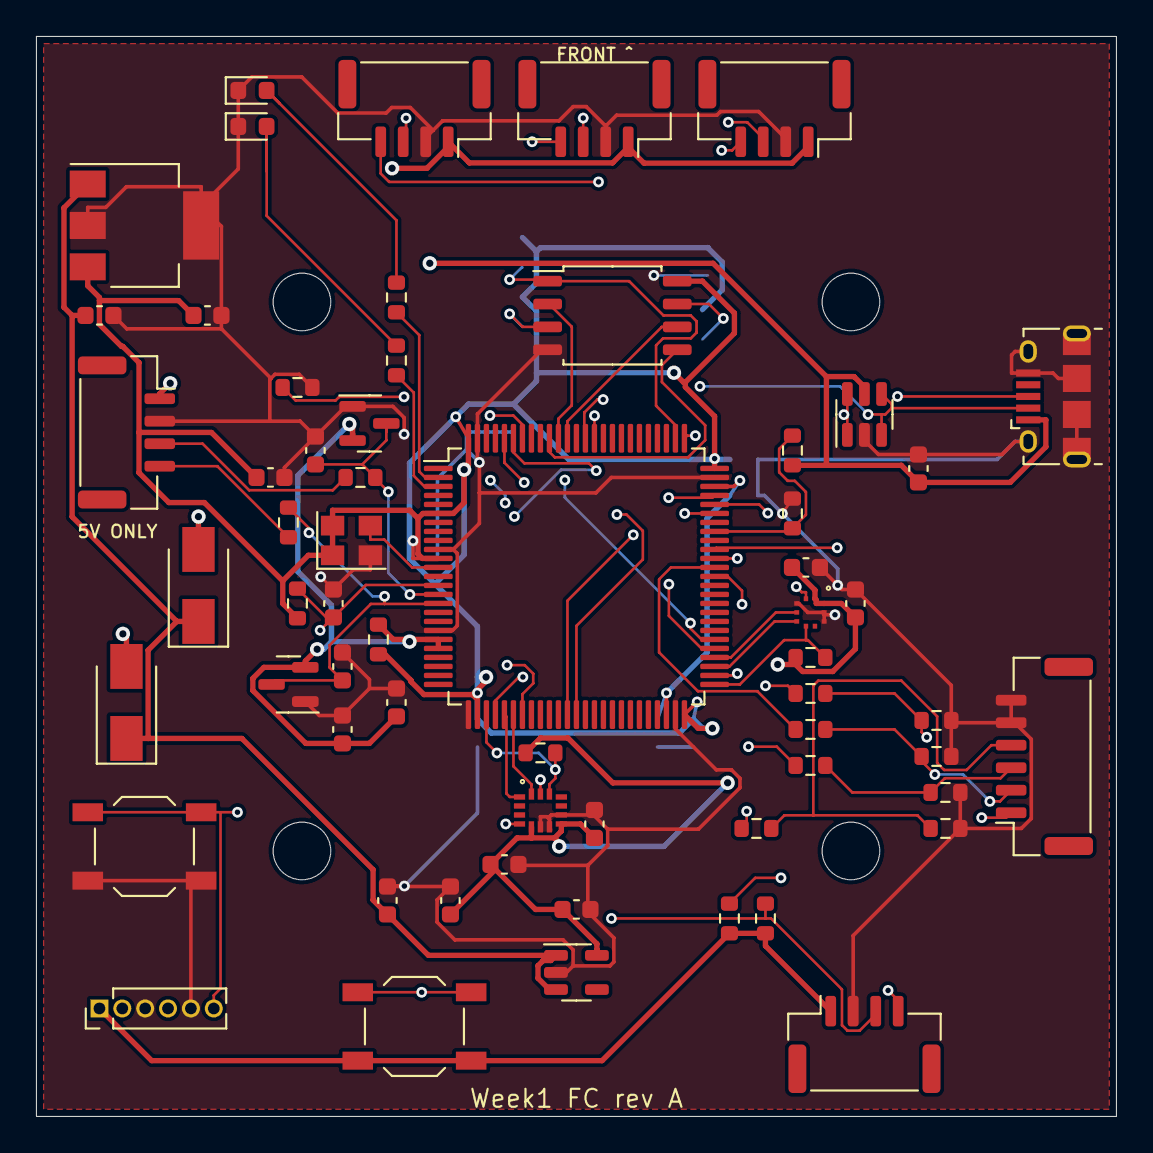
[picture p10: board Week1.kicad_pcb from above]

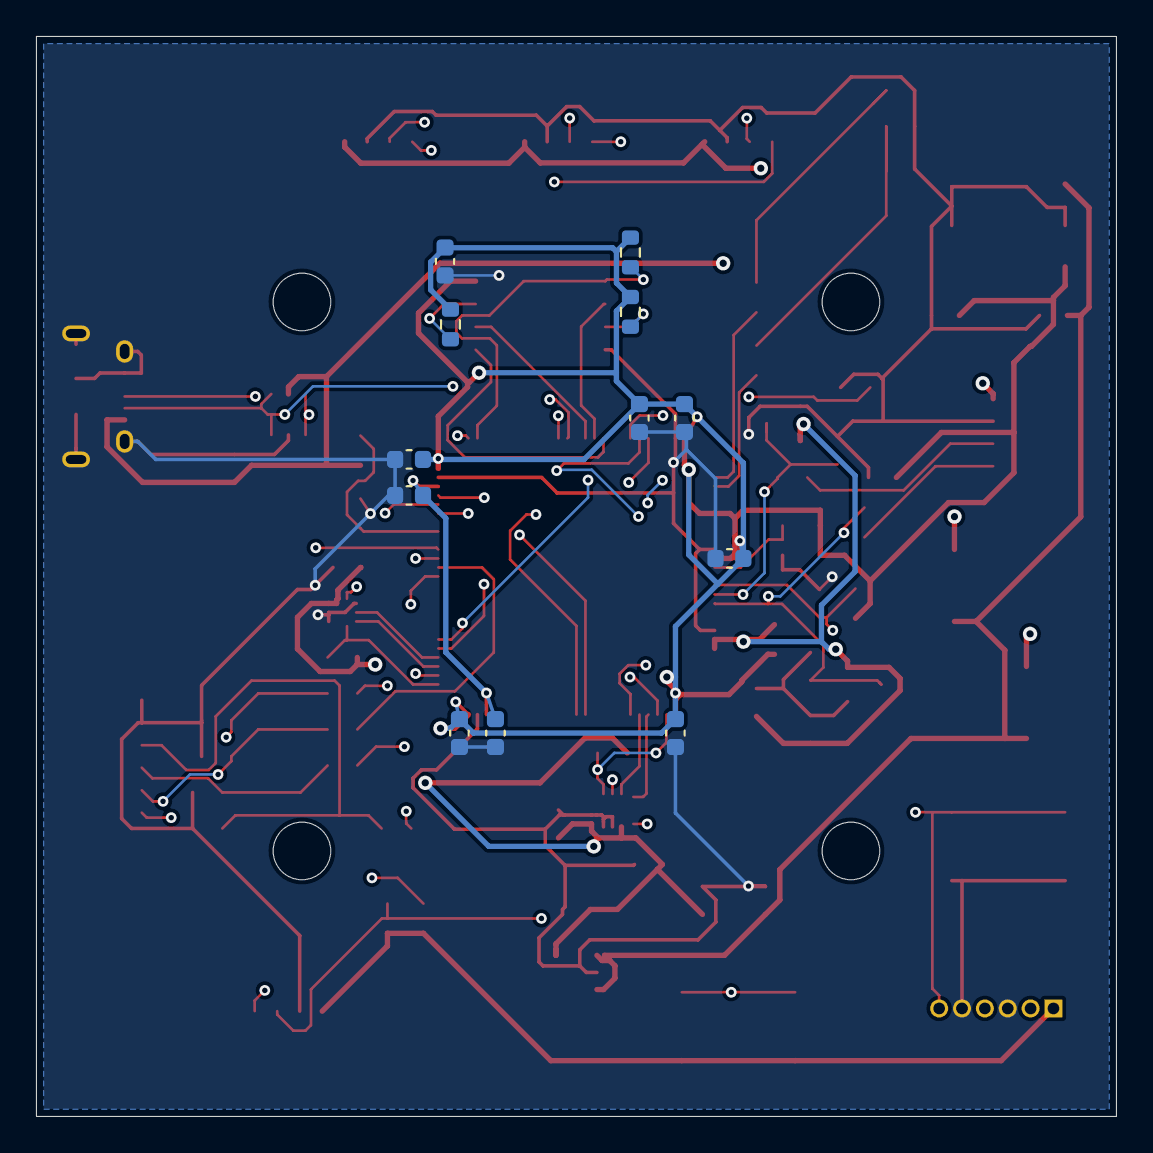
[picture p11: board Week1.kicad_pcb from below]

Board: 4 copper layers, 60.0 x 60.0 mm, 77 parts (12 on the bottom side), 55 nets.

Other parts of the board:
H1, H2, H3, H4: MountingHole_3.2mm_M3
