DVeldhurthi/halflifeweek1/(commit log)

2026-10-12 Add Week1 KiCad flight controller
    [Core.kicad_sch, Interfaces.kicad_sch, Power.kicad_sch, Sensors.kicad_sch, Week1.kicad_pcb, Week1.kicad_sch]
2026-10-12 Add BeginnerFC board image to README
